hudaubaya/padan/rtl/README.md

# rtl/

RTL milik PADAN. Baseline TT07 yang disalin apa adanya ada di
[`baseline/`](baseline/) — jangan diubah; lihat [`docs/baselines.md`](../docs/baselines.md).
