hudaubaya/padan/tb/README.md

# tb/

Testbench cocotb untuk RTL PADAN (satu subdirektori per blok). Test baseline
TT07 tetap memakai testbench upstream di `rtl/baseline/<nama>/test/`.
