hudaubaya/padan/docs/laporan_padan.md

---
title: Laporan Proyek PADAN
subtitle: Identifikasi 1:N INT8 dengan ABFT, dari model hingga integrasi FPGA Kria KV260
date: Per 22 Oktober 2026 · repositori hudaubaya/padan, RTL terakhir berubah di PR #13 (atribut fsm_encoding)
lang: id-ID
---

<!--
Sumber laporan. docs/laporan/Laporan_PADAN.docx dibangkitkan dari berkas ini:
    make laporan
`make check-laporan` (bagian dari `make test`) gagal bila .docx tidak sinkron.
Angka di sini ditulis tangan dari docs/ dan log CI; perbarui saat repo berubah.
-->

# Ringkasan

PADAN sudah memiliki golden model, RTL lengkap, antarmuka bus (inti gaya
Avalon-MM dengan wrapper AXI4-Lite), penjaga keamanan (guard), dan paket
integrasi Kria KV260 (proyek Vivado dan host Python di Linux PS). Semuanya
terbukti **di simulasi** dan lulus CI. **Build Vivado 2026.1 sudah dijalankan
pengguna** dan lulus pemeriksaan timing, register redundan, dan CDC. Empat FSM
yang dikode ulang sudah diperbaiki di RTL, tetapi belum di-build ulang.
**Hasil board pertama** (dilaporkan pengguna, bitstream build pertama):
`padan_test.py` lulus 46/46 di KV260, dua kali berturut-turut. Uji tamper PMOD dan
bitstream dengan RTL terbaru belum dijalankan di board.

- **Fungsi:** 16 template × 128 byte INT8, skor s_j = Σ T[j,i]·p_i, keputusan
  MATCH / NO_MATCH / FAULT dengan latensi tetap 153 siklus.
- **Keamanan fault:** dari 48.765 fault bit tunggal yang disuntikkan lewat
  antarmuka bus, tidak satu pun menghasilkan MATCH yang salah.
- **Keamanan sistem:** pembatas percobaan, LOCK dengan τ terkunci, zeroize saat
  tamper atau FAULT berulang, dan FSM safe-state yang dibuktikan dengan SAT
  (Yosys).
- **Estimasi sumber daya (Yosys, K26):** semua di bawah 6% kapasitas. Masalah
  DSP di Cyclone V (9,8–17%) tidak berlaku lagi: 19 DSP48E2 = 1,5%.
- **Hasil Vivado 2026.1 (build pengguna, 21 Oktober 2026):**
  - Timing 100 MHz terpenuhi: WNS +3,68 ns, WHS +0,025 ns.
  - `padan_axil` memakai 1.559 LUT, 2.009 FF, 16 RAMB18, dan 21 DSP48E2.
  - FF `decision` 151 dan `guard` 103; FSM `guard` tidak dikode ulang.
  - CDC hanya ada pada `tamper_n`.

  Ada dua temuan:
  - `mac_array` memakai 18 DSP, bukan 16 (bagian 8).
  - Empat FSM lain dikode ulang Vivado. Sebagai tanggapan, `fsm_encoding =
    "none"` sudah dipasang, tetapi belum di-build ulang (risiko 5).
- **Hasil board KV260 (22 Oktober 2026, dilaporkan pengguna):**
  - Bitstream termuat lewat `xmutil loadapp padan`.
  - `pl_clk0` berjalan pada 99.999.999 Hz.
  - GUARD_STATUS awal `0x00000503` (OPEN).
  - `padan_test.py` lulus 46/46, dan hasil yang sama terulang dengan `exit 0`
    (bagian 5).
- **Temuan saat port:** Yosys untuk Xilinx menggabungkan FF kode STATUS
  sehingga jarak NO_MATCH → MATCH turun dari 4 ke 2 flip FF. Sudah diperbaiki
  (bagian 4).
- **Status:** RTL terakhir berubah di PR #13 (5b854d6, 22 Oktober 2026), yaitu
  atribut `fsm_encoding = "none"` di empat FSM. Logikanya tidak berubah. Sebelumnya RTL
  berubah di port KV260 (PR #8, 65e3eb8). Setiap merge
  dilakukan setelah CI hijau dan log-nya diperiksa. `make test` juga lulus
  (exit 0) di laptop pengguna (WSL), di luar CI.

## Cara membaca label

| Label | Arti |
|---|---|
| [Pasti] | Dibuktikan oleh simulasi, bukti formal, aljabar, atau struktur netlist di repo ini. |
| [Kemungkinan Besar] | Inferensi kuat yang belum dibuktikan di sini, misalnya perilaku Vivado. |
| [Menebak] | Mengisi celah informasi; perlu dicek. |
| (model) | Angka dari golden model Python, bukan dari RTL, FPGA, atau silikon. |
| estimasi Yosys | Pemetaan Yosys `synth_xilinx -family xcup`, bukan laporan Vivado. |

# Kronologi

Tahap 1–10 dilakukan pada 6 Oktober 2026, tahap 11–16 pada 17–22 Oktober 2026.
Setiap pull request di-merge setelah CI hijau.

| Tahap | Commit / PR | Isi |
|---|---|---|
| 1. Kerangka dan baseline | c319f85 | Struktur repo; tiga desain TT07 disalin apa adanya beserta lisensi dan SHA256SUMS |
| 2. Audit baseline | ecbc278 | Ketiga baseline diuji apa adanya (RTL dan netlist gate-level) terhadap model Python |
| 3. Golden model | d1a274d (PR #1) | Model integer PADAN, analisis batas 32 bit, data sintetis INT8 vs float, simulasi fault |
| 4. RTL inti | 982d2a6 (PR #2) | `template_mem`, `mac_array`, `abft_check` + test cocotb dan uji mutasi |
| 5. Keputusan dan bus | 4210629 (PR #3) | `decision` (dua komparator), `padan_avmm` (slave Avalon-MM), paritas probe |
| 6. FPGA DE10-Nano | 1ed2f89 (PR #4) | Komponen Platform Designer, skrip GHRD, SDC, skrip System Console |
| 7. Guard | 811f8ce (PR #5) | Pembatas percobaan, LOCK + τ terkunci, FAULT, tamper (KEY0 di DE10-Nano), zeroize, safe-state |
| 8. Injeksi fault debug | 2e694e4 (PR #6) | Port `DEBUG_FAULT` dan bukti bahwa build rilis tidak memuatnya |
| 9. Estimasi sumber daya | (tanpa commit) | Yosys `synth_intel_alm` per modul (Cyclone V; diganti di tahap 11) |
| 10. Laporan | 89875e3 (PR #7) | Laporan ini (Markdown → .docx), `make check-laporan` |
| 11. Port Kria KV260 | 65e3eb8 (PR #8) | `padan_axil` (AXI4-Lite), proyek Vivado, XDC tamper PMOD, host Python, inferensi UltraScale+, perbaikan `code_lo_n`; berkas DE10-Nano dihapus |
| 12. Perkakas `make` | da3e2ee (PR #10) | Pesan jelas bila cocotb belum terpasang; self-test `check_reports.py` tanpa baris FAIL palsu |
| 13. Uji di luar CI | (tanpa commit) | `make test` exit 0 di laptop pengguna (WSL) setelah `git pull` ke main yang memuat PR #10 |
| 14. Build Vivado pengguna | 5b854d6 (PR #13); laporan di `fpga/kv260/testdata` | Vivado 2026.1: timing, clock, register redundan, dan CDC lulus; 4 FSM dikode ulang, lalu `fsm_encoding = "none"` dipasang; `check_reports.py` kini juga memeriksa clock, CDC, dan FSM, dan diuji terhadap laporan asli |
| 15. Board KV260 pertama | (tanpa commit; dilaporkan pengguna) | Bitstream build pertama: `xmutil loadapp`, `pl_clk0` 99.999.999 Hz, `padan_test.py` PASS 46/46 dua kali |
| 16. Demo webcam | `sw/kv260/padan_cam.py` | Skrip pengguna masuk repo; galeri persisten (nama + template INT8, 0600) supaya wajah tetap dikenali di sesi baru; self-test di CI |

# 1. Baseline TT07 dan audit

Tiga desain Tiny Tapeout 07 disimpan **tanpa modifikasi** pada commit yang
di-tapeout. `make check-baseline` gagal bila satu byte berubah. Audit menguji
RTL dan netlist tapeout (sky130) dengan cocotb terhadap model maksud desain
(`docs/baseline_audit.md`).

| Baseline | Yang benar | Cacat yang ditemukan | Dipakai ulang |
|---|---|---|---|
| TinyTPU #0590 | Array sistolik 2×2 benar untuk 400 pasang matriks acak | `tx_ready` terlambat; akumulator 16 bit overflow; operasi kedua tanpa reset salah; 32 latch; register tanpa reset (X di netlist) | Konsep `mac.v` + `systolic.v`; kendali I/O ditulis ulang |
| Iterative MAC #0040 | Pengali 7×8 benar untuk 32.768 pasangan | Mode 0 selalu 0; `uio` dipakai dua arah; cabang mati; hasil terpotong | Hanya konsep |
| Vector CiSRAM #0642 | Dot product 8 elemen eksak; CLA terbukti formal (SAT) | Tidak ada cacat fungsional; hanya tak bertanda; tidak ada SRAM sungguhan | Ya: `MAC` dan `cla` |

16 test cacat ditandai `expect_fail`. Suite menjadi merah bila perilaku
baseline berubah, tanda dokumen audit perlu diperbarui. Nomor TT07 belum dicek
terhadap tinytapeout.com. [Kemungkinan Besar]

# 2. Golden model dan analisis

`model/padan.py` mendefinisikan skor, baris checksum C dan Cw, residu ABFT d1
dan d2, dan lokalisasi k = d2/d1 − 1. Semua angka di bagian ini berlabel
(model); rinciannya di `docs/padan_model.md`.

- **Semua besaran muat 32 bit bertanda.** [Pasti] Yang terbesar tanpa fault
  adalah Cw·p = 285.212.672 (model, 30 bit), dengan ruang sisa 7,53× terhadap
  2^31 − 1.
- **Baris checksum tidak muat INT8:** C butuh 12 bit dan Cw 16 bit, sehingga
  lane harus 16×8, bukan 8×8. [Pasti]
- **INT8 vs float:** kesepakatan keputusan ≥ 99,882% (model) untuk τ 0,15–0,50.
  Semua beda berada dalam 0,0047 dari ambang. FAR/FRR absolut tidak bermakna
  untuk biometrik nyata, karena data ini sintetis.
- **Fault tunggal:** deteksi 100% (model) untuk semua flip efektif. Pemeriksa
  32 bit salah tunjuk untuk flip bit 27–31 pada skor; pemeriksa 40 bit atau cek
  rentang memberi lokalisasi 100%. RTL memakai 40 bit.
- **Celah yang ditemukan model:** fault pada probe p tidak terlihat oleh ABFT.
  65.536 flip tidak terdeteksi, 229 di antaranya mengubah keputusan (model).
  Celah ini ditutup di RTL dengan paritas per byte.
- **Fault ganda:** dua flip bit 31 bisa saling meniadakan pada pemeriksa 32 bit,
  dan dua fault bisa salah lokalisasi. Lokalisasi cukup untuk pelaporan, tidak
  untuk koreksi otomatis.

# 3. RTL inti

Tiga modul Verilog-2001 dengan parameter rilis N = 16, D = 128, L = 16 lane
(`docs/rtl_padan.md`).

| Modul | Isi |
|---|---|
| `template_mem` | 16 bank block RAM × 144 word × 16 bit (T, C, Cw); hanya bisa ditulis; generator memperbarui C dan Cw di setiap tulis byte |
| `mac_array` | 16 lane MAC 16×8, adder tree, akumulator 32 bit; satu dot product per 8 siklus; 18 baris per MATCH (16 skor + C·p + Cw·p); probe 1.024 bit dengan paritas per byte |
| `abft_check` | S1, S2, d1, d2 dalam 40 bit; lokalisasi tanpa pembagi, maksimal 16 langkah |

- **38.112 fault** (lane, akumulator, setiap bit memori) terdeteksi dengan indeks
  benar; tidak ada alarm palsu pada 1.317 run bersih. [Pasti]
- **Biaya ABFT:** 16 siklus (+12,5%) untuk dua baris checksum.
- **Uji mutasi:** mutan `no_c`, `no_cw`, dan `weight_j` terbunuh. Mutan `no_c` dan
  `no_cw` membuktikan bahwa test tanpa fault saja tidak cukup, karena pemeriksa
  yang setengah mati tetap diam.

# 4. Keputusan dan antarmuka bus

`decision.v` memakai dua komparator yang ditulis berbeda (diversitas). τ di
komparator B disimpan sebagai komplemen; tanpa itu Yosys menggabungkan register
keduanya. `padan_avmm.v` adalah inti dengan slave Avalon-MM internal tanpa jalur
baca untuk template, probe, atau skor (`docs/rtl_decision.md`). Di KV260 ia
dibungkus `padan_axil.v` (AXI4-Lite) tanpa mengubah peta register.

| Kode STATUS | Arti |
|---|---|
| `0000` | NONE (belum ada keputusan) |
| `0101` | NO_MATCH (tanpa indeks, agar identitas terdekat tidak bocor) |
| `1010` | MATCH; indeks dikeluarkan dua kali (idx dan ~idx) |
| `1111` | FAULT: ABFT gagal, paritas probe salah, atau komparator tidak sepakat |

- **814 keputusan** identik dengan model, termasuk seri dan nilai ekstrem.
- **48.765 fault** (datapath, memori, probe, register komparator, sinyal error,
  register keluaran): tidak satu pun menghasilkan MATCH yang salah. [Pasti]
- **Latensi tetap 153 siklus** untuk MATCH, NO_MATCH, dan FAULT, sehingga tidak
  ada kanal samping waktu.
- **Mutan `no_parity`** membuktikan temuan model: satu flip bit probe tanpa
  paritas membuat impostor MATCH.
- **Kode STATUS harus bertahan di netlist.** Kedua setengah kode legal selalu
  sama, dan Yosys `synth_xilinx` menggabungkan FF `code[1:0]` dengan
  `code[3:2]` (`synth_intel_alm` tidak). Akibatnya NO_MATCH → MATCH hanya butuh
  2 flip FF, bukan 4. [Pasti, Yosys] Perbaikan: setengah bawah disimpan terbalik
  (`code_lo_n`); FF `decision` kembali 151 di kedua alur, dan test fault kini
  membalik FF yang sebenarnya.

# 5. Integrasi FPGA Kria KV260

Board target sekarang Kria KV260 (Zynq UltraScale+ K26). Paket DE10-Nano
(tahap 6) dihapus. Build Vivado 2026.1 sudah dijalankan pengguna (21 Oktober
2026), dan bitstream-nya sudah diuji di board KV260 oleh pengguna (22 Oktober
2026, hasil di bawah).

| Bagian | Isi |
|---|---|
| `rtl/padan_axil.v` | Slave AXI4-Lite di atas `padan_avmm`. AW/W boleh datang dalam urutan apa pun; WSTRB ≠ `1111` → SLVERR tanpa efek; B ditahan sampai inti menerima tulis (zeroize, byte template). |
| `fpga/kv260/create_project.tcl` | Part `xck26-sfvc784-2LV-c`, board part KV260, PS → `M_AXI_HPM0_FPD` → SmartConnect → `padan_0` di `0xA000_0000` (4 KiB), `pl_clk0` 100 MHz. |
| `fpga/kv260/padan_kv260.xdc` | `tamper_n` di H12 (PMOD J2), LVCMOS33, pull-up, false path. H12/LVCMOS33 dikutip dari XDC resmi Xilinx Kria-PYNQ. [Pasti] Bahwa itu pin fisik 1 di J2: [Kemungkinan Besar]. |
| `fpga/kv260/build.tcl`, `check_reports.py` | Bitstream, laporan, XSA; pemeriksaan RAMB18 16, DSP `mac_array` 16–18, FF `decision` 151, `guard` 103, WNS/WHS/WPWS ≥ 0, `clk_pl_0` 10 ns, CDC hanya `tamper_n`, tidak ada FSM modul PADAN yang dikode ulang. |
| `sw/kv260/padan_test.py` | Host di Linux PS lewat `/dev/mem` (pustaka standar Python). Identifikasi baca-saja sebelum menulis; 3 galeri, 46 kasus dari model, pindai 1.024 word. |
| `sw/kv260/padan_cam.py` | Demo webcam: YuNet + SFace (128-D) → INT8 → PADAN. Galeri nama + template INT8 disimpan di `padan_galeri.json` (izin 0600, tidak dienkripsi, diabaikan git) dan ditulis ulang ke PADAN setiap skrip mulai. Self-test di CI tanpa kamera; kamera dan akurasi wajah nyata belum diuji. |

- **Yang diuji di CI tanpa Vivado dan board:**
  - `padan_axil`: 6 test protokol (urutan AW/W, backpressure B/R, SLVERR, AR
    bersamaan, tamper) dan 8 mutan, semua terbunuh. [Pasti]
  - `padan_test.py` tanpa diubah melawan RTL lewat AXI: 46/46 PASS tanpa
    pelanggaran protokol; fault memori terdeteksi dan HALT setelah FAULT ke-3;
    base salah tidak menulis apa pun. [Pasti, simulasi]
  - Skrip Vivado di tclsh dengan stub: nilai kunci konsisten dengan RTL dan
    host, 4 kondisi error memberi pesan jelas.
- **Dijalankan pengguna di luar CI:** build Vivado 2026.1 (lulus),
  pembangkitan `pl.dtsi`, dan uji di board (tabel berikut).

**Hasil board KV260** (22 Oktober 2026; dijalankan dan dilaporkan pengguna;
bitstream build pertama, sebelum `fsm_encoding` ditambahkan di PR #13). Output
perintah dikutip apa adanya:

| Butir | Hasil |
|---|---|
| `xmutil loadapp padan` | `padan: loaded to slot 0`; `listapps` menunjukkan `padan` di slot 0 |
| `dmesg` | Peringatan overlay "memory leak will occur if overlay removed" (umum, tidak berbahaya [Kemungkinan Besar]); pada pemuatan pertama `set divider failed for pl0_ref_div1, ret = -13` |
| `clk_summary` | `pl0_ref` 99.999.999 Hz (`pl0_ref_mux` 1.499.999.985 Hz ÷ 15), aktif |
| GUARD_STATUS awal | `0x00000503` (OPEN, gagal 0/5, alasan BOOT) |
| `padan_test.py` run 1 | `PADAN KV260: PASS (46 kasus, 3 galeri, pindai alamat bersih)` |
| `padan_test.py` run 2 (`timeout 120`) | PASS yang sama, `exit 0` |
| Uji tamper PMOD | belum |
| Bitstream RTL terbaru (PR #13) | belum |

- **Error divider clock tidak berdampak:** frekuensi akhirnya sesuai permintaan
  `pl.dtsi` dan tidak melebihi 100 MHz, sehingga margin timing Vivado tetap
  berlaku [Pasti, dari `clk_summary`].
- **Satu run yang dihentikan dengan Ctrl+C** (exit 130) tidak dihitung. Run
  ulang dengan `timeout` lulus.
- **Yang terbukti:** jalur PS → SmartConnect → `padan_axil` → inti, 46
  keputusan yang sama dengan model, dan pindai 1.024 alamat yang bersih.
  Hasilnya hanya berlaku untuk board, bitstream, dan versi repo itu.
- **Tidak tercakup:** tamper fisik, zeroize memori yang sebenarnya (tidak ada
  jalur baca template), dan perilaku di bawah fault nyata.

# 6. Guard: keamanan di tingkat sistem

`guard.v` mengendalikan izin bus. Setiap reset melakukan zeroize sebelum
perangkat bisa dipakai (`docs/rtl_guard.md`).

| Fungsi | Perilaku |
|---|---|
| Pembatas percobaan | K = 5 NO_MATCH berturut-turut → LOUT (keluar hanya lewat reset); MATCH menolkan penghitung |
| LOCK | Setelah LOCK, template tidak bisa ditulis atau dihapus; probe dan MATCH tetap bisa |
| τ terkunci | Di LOCKD, decision memakai GUARD_TAU, bukan τ dari host |
| FAULT | Penghitung kumulatif; FAULT ke-3 → zeroize → HALT |
| Tamper | Pin PMOD J2 (KV260), sinkronisasi 2-FF → zeroize → HALT |
| Safe-state | State 4 bit berparitas genap; kode ilegal atau ketidakcocokan penghitung/komplemen → zeroize → HALT |

**τ terkunci tidak ada di spesifikasi awal.** Tanpanya, host cukup menulis
τ = −2^31 untuk mendapat MATCH dan menolkan penghitung, sehingga pembatas
percobaan tidak berarti. [Pasti]

- 9 test dengan parameter rilis. Zeroize dibuktikan dengan memindai seluruh
  16 × 144 word memori dan register probe di simulasi.
- Bukti SAT Yosys setelah sintesis: setiap state ilegal mematikan semua izin dan
  menuju zeroize; ada kontrol negatif.
- 12 mutan guard terbunuh, termasuk clear yang melewatkan baris checksum dan
  sinkronisasi tamper 1-FF.

# 7. Injeksi fault debug (DEBUG_FAULT)

Build debug punya register DBG_FAULT untuk menambahkan delta ke produk satu
lane, serta DBG_ABFT untuk membaca hasil lokalisasi. Build rilis **tidak
memuat** port, register, atau logikanya (`docs/rtl_debug_fault.md`).

- **Delta aditif, bukan pengganti.** Dengan delta aditif, residu ABFT hanya
  bergantung pada delta dan baris. Dengan nilai pengganti, residu membocorkan
  T·p. [Pasti, aljabar]
- 288 injeksi (16 lane × 18 baris): semuanya FAULT; 256 dilokalisasi ke
  barisnya, 32 terdeteksi di baris checksum.
- Bukti build rilis: hasil praproses dan netlist Yosys sebelum optimasi tidak
  memuat jejak `dbg`; build debug dipakai sebagai kontrol positif.

# 8. Estimasi sumber daya

Estimasi Yosys (`synth_xilinx -family xcup -flatten`) untuk Zynq UltraScale+
K26 dengan parameter rilis. LUT = LUT1–LUT6; FF = FDRE/FDCE/FDPE/FDSE. Kapasitas:
1.248 DSP dari data AMD; LUT, FF, dan block RAM dari ingatan atas tabel K26 dan
belum dicek ke datasheet DS987. [Kemungkinan Besar]

| Modul | LUT | FF | DSP48E2 | Block RAM |
|---|---|---|---|---|
| `mac_array` | 3.121 | 1.866 (+11 SRL16E) | 16 | – |
| `abft_check` | 474 | 290 | 2 | – |
| `template_mem` | 286 | 86 | 1 | 16 RAMB18E2 |
| `decision` | 135 | 151 | – | – |
| `guard` | 169 | 103 | – | – |
| `padan_avmm` (inti) | 4.309 | 2.559 | 19 | 16 RAMB18E2 |
| **`padan_axil` (top KV260)** | **4.358** | **2.631** | **19** | **16 RAMB18E2** |

| Sumber daya | Estimasi | Kapasitas K26 | % |
|---|---|---|---|
| LUT | 4.358 | ± 117.120 | 3,7% |
| FF | 2.631 | ± 234.240 | 1,1% |
| RAMB18 | 16 | ± 288 | 5,6% |
| DSP48E2 | 19 | 1.248 | 1,5% |

**Keputusan DSP dari Cyclone V tidak diperlukan lagi.** Di Cyclone V, 19
pengali menjadi 11–19 blok DSP (9,8–17%). Di K26 satu DSP48E2 memuat satu
pengali 16×8, dan totalnya 1,5%. Menghapus 3 pengali di `abft_check` dan
`template_mem` tidak lagi sepadan dengan risiko mengubah RTL yang sudah
terverifikasi.

Angka yang dikunci CI adalah jumlah primitif keras dan FF register redundan,
bukan LUT.

**Hasil Vivado 2026.1** (build pengguna, 21 Oktober 2026; laporan asli di
`fpga/kv260/testdata/vivado_2026.1`) [Pasti untuk build itu]:

| Modul | LUT | FF | DSP48E2 | Block RAM |
|---|---|---|---|---|
| `mac_array` | 520 | 1.237 (+11 SRL) | 18 | – |
| `abft_check` | 240 | 280 | 2 | – |
| `template_mem` | 197 | 86 | 1 | 16 RAMB18 |
| `decision` | 165 | 151 | – | – |
| `guard` | 424 | 103 | – | – |
| **`padan_axil`** | **1.559** | **2.009** | **21** | **16 RAMB18** |
| Seluruh desain (dengan SmartConnect) | 1.996 | 2.459 | 21 | 16 RAMB18 |

- **DSP `mac_array` = 18, bukan 16 seperti Yosys.**
  - Daftar sel DSP menunjukkan 16 DSP lane yang menyerap `g_sum4[*].sum` lewat
    kaskade, ditambah 2 DSP (`tree0`, `tree_reg`) sebagai adder `tree`.
  - Akumulator `acc` tetap di fabric.
  - Tidak ada pengali yang dipecah, jadi tidak ada yang perlu diubah di RTL.
    `check_reports.py` kini menerima 16–18 DSP.
- **`guard` memakai 424 LUT di Vivado, sedangkan Yosys 169.** Netlistnya jelas
  berbeda, dan bukti SAT safe-state hanya berlaku untuk netlist Yosys
  (risiko 1).
- **Timing.** Jalur terlambat ada di `template_mem`, dari block RAM ke DSP
  `g_wdelta`, dengan slack 3,68 ns pada 10 ns.

# 9. Verifikasi dan CI

`make test` menjalankan semua target di bawah: 30 menit lokal, 33 menit di CI
(job `cocotb` PR #8, 04:55–05:28 UTC, 17 Oktober 2026). CI GitHub
Actions menjalankannya di setiap PR dan setiap push ke main. Setiap merge
dilakukan setelah CI hijau dan log-nya diperiksa.

Di luar CI, `make test` butuh `python3 -m pip install -r requirements.txt`
(cocotb 1.8.1, numpy) serta Icarus Verilog, Yosys, tclsh, dan pandoc. Tanpa
cocotb, setiap target simulasi berhenti dengan pesan yang menyebut perintah
pemasangan itu (PR #10).

Pada 20 Oktober 2026 `make test` dijalankan di laptop pengguna (WSL, venv
Python) dan selesai dengan exit 0. Ini mereproduksi hasil CI di mesin kedua,
bukan bukti Vivado atau board.

**Cara membaca output.** Ukurannya adalah exit code `make test` (0 = semua
target lulus), bukan ada atau tidaknya kata "FAIL". Kata itu memang muncul pada
hasil yang benar:

- di kepala tabel ringkasan cocotb (`FAIL=0`);
- pada log test negatif `tb/kv260`, yang sengaja membuat skrip host gagal
  (memori dibalik → `PADAN KV260: FAIL … HALT`; guard LOCKD → skrip menolak);
  test-nya sendiri lulus bila skrip melaporkan FAIL.

`SKIP=1` pada dua audit gate-level (`tinytpu`, `iterative_mac`) juga wajar: test
yang membaca sinyal internal RTL dilewati karena sinyal itu tidak ada di
netlist. Baris yang diawali `FAIL` di awal baris (`grep "^FAIL"`) tidak boleh
ada. Kode sebelum PR #10 masih mencetak lima baris seperti itu dari kasus
negatif self-test `check_reports.py`; bila muncul, salinan lokal belum
diperbarui.

| Target | Isi | Hasil terakhir |
|---|---|---|
| `check-baseline`, `test-baseline`, `test-audit` | Integritas baseline, test upstream, audit RTL + gate-level + bukti SAT CLA | lulus |
| `test-model`, `check-model-report` | Self-test model; dokumen model sinkron | lulus |
| `test-rtl` | Inti RTL vs model, 38.112 fault | 7/7 |
| `test-rtl-avmm` | Bus + decision, 814 keputusan, 48.765 fault | 7/7 |
| `test-rtl-guard` | Guard, parameter rilis | 9/9 |
| `check-rtl-guard-safe` | Bukti SAT safe-state | 21 bukti |
| `test-rtl-mutation` | Mutan RTL harus terbunuh (3 inti, 3 decision, 12 guard, 8 AXI) | 26/26 |
| `check-rtl-infer` | Yosys UltraScale+: 16 RAMB18E2, 16 + 3 DSP48E2, tanpa LUTRAM; FF `decision` 151, `guard` 103 | lulus |
| `test-rtl-debug`, `check-rtl-release` | Build debug; bukti build rilis bersih (termasuk port `padan_axil`) | 4/4; PASS |
| `test-rtl-axil` | Wrapper AXI4-Lite, monitor protokol | 6/6 |
| `test-kv260-scripts` | Skrip Vivado (stub), parser laporan (laporan asli Vivado 2026.1 + 13 kasus negatif), host KV260 vs RTL lewat AXI | 5/5 |

# 10. Batas dan risiko terbuka

1. **Uji board baru sebagian.** `padan_test.py` lulus di board dengan bitstream
   build pertama (bagian 5). Tamper fisik dan bitstream terbaru belum diuji.
   Klaim keamanan fault tetap berasal dari simulasi RTL.
   - Build Vivado 2026.1 sudah memastikan beberapa hal: timing 100 MHz, jumlah
     FF register redundan, block RAM/DSP, dan FSM `guard` yang tidak dikode
     ulang.
   - Logika safe-state baru dibuktikan dengan SAT pada netlist Yosys. Netlist
     `guard` di Vivado berbeda (424 LUT, Yosys 169).
2. **Pemuatan bitstream di Linux KV260** (overlay device tree, `xmutil`) adalah
   bagian paling tidak pasti; tanpa overlay `pl_clk0` mungkin mati dan akses
   AXI menggantung. [Menebak] Status saat ini:
   - Overlay dari `pl.dtsi` sudah berhasil dimuat di board dengan `xmutil`.
   - `pl_clk0` berjalan pada 99.999.999 Hz.
   - `firmware-name` (`padan_kv260.bit.bin`) sudah disesuaikan di panduan.
   - Sisa risiko: image Linux atau firmware lain bisa berperilaku berbeda,
     misalnya error divider clock yang muncul saat pemuatan pertama.
3. **Template selalu ada di luar chip.** Keadaan guard volatil dan setiap reset
   menghapus template, jadi host harus mengirim ulang template setiap boot.
   - `padan_cam.py` melakukannya dari `padan_galeri.json`.
   - Berkas itu berisi template wajah sukarelawan dan tidak dienkripsi;
     perlindungannya hanya izin 0600 (root).
   - Siapa pun yang punya akses root atau kartu SD bisa membaca template, jadi
     perlindungan zeroize di FPGA tidak berlaku untuk salinan di host.
4. **Pembatas hanya menghitung kegagalan berturut-turut.** Penyerang dengan satu
   probe sah bisa menyelipkannya setiap 4 percobaan.
5. **Fault kendali belum disimulasikan:** sequencer, tag baris, FSM. Flip pada
   tag baris bisa membuat ABFT dan kedua komparator salah secara konsisten.
   [Kemungkinan Besar]
   - Vivado 2026.1 mengode ulang FSM `template_mem` dan `abft_check`
     (sequential) serta `padan_avmm` dan `padan_axil` (one-hot) [Pasti, log
     sintesis].
   - Cabang `default` di RTL, yaitu jalan pulang ke IDLE dari state ilegal,
     kemungkinan besar hilang. Satu flip pada register one-hot bisa membuat bus
     atau sequencer macet sampai reset [Kemungkinan Besar].
   - Perbaikannya: `fsm_encoding = "none"` dipasang pada keempat register
     (22 Oktober 2026). Simulasi tidak terpengaruh. Yosys juga mematuhinya:
     estimasi `padan_axil` naik dari 4.248 menjadi 4.358 LUT, dan jumlah DSP,
     block RAM, serta FF register redundan tidak berubah [Pasti].
   - Sudah di-merge di PR #13 (5b854d6). Efeknya di Vivado dan board belum
     diverifikasi; perlu build ulang.
6. **Fault ganda** bisa salah lokalisasi; lokalisasi tidak boleh dipakai untuk
   koreksi otomatis.
7. **Flip dua bit** bisa membawa LOCKD ke OPEN; flip satu bit selalu tertangkap.
8. **Bitstream debug adalah alat DoS** dan bisa dibangun lewat `verilog_define`
   Vivado di luar repo. Penandanya STATUS[31] = 1.
9. **Tamper PMOD dengan pull-up internal** peka terhadap kabel lepas atau
   sentuhan ke GND; satu glitch sudah menghapus enrollment.
10. **Hasil INT8 vs float memakai data sintetis;** tidak ada klaim akurasi
   biometrik nyata. `padan_cam.py` memakai ambang kosinus SFace float (0,363)
   yang belum dikalibrasi untuk INT8 dengan wajah nyata.

# 11. Langkah berikutnya

1. **Build ulang di Vivado** setelah `fsm_encoding = "none"` dipasang di empat
   FSM (risiko 5), lalu jalankan `check_reports.py`. Pemeriksaan FSM harus
   PASS, dan angka utilisasi serta timing dibandingkan dengan build pertama.
2. **Cek pin H12 = PMOD J2 pin 1** di skematik carrier KV260 sebelum menyambung
   kabel tamper.
3. **Uji di board dengan bitstream baru:** `padan_test.py` (harus PASS
   46/46), lalu uji tamper PMOD manual (`docs/fpga_howto.md` bagian 7).
4. **Pertimbangkan penghitung kegagalan total atau pembatas laju** bila ancaman
   probe sah relevan.
5. **Tambah simulasi fault kendali** (sequencer, tag baris) atau duplikasi
   kendali.
