hudaubaya/padan/tb/common/tb_tt.v

// Toplevel audit untuk satu proyek Tiny Tapeout, level pin saja.
// TT_TOP = nama top module (didefinisikan oleh tb/audit/audit.mk). Dengan
// GL_TEST, DUT adalah netlist tapeout yang membutuhkan pin daya.
`default_nettype none
`timescale 1ns / 1ps

module tb ();
  reg        clk;
  reg        rst_n;
  reg        ena;
  reg  [7:0] ui_in;
  reg  [7:0] uio_in;
  wire [7:0] uo_out;
  wire [7:0] uio_out;
  wire [7:0] uio_oe;

`ifdef WAVES
  initial begin
    $dumpfile("tb.vcd");
    $dumpvars(0, tb);
  end
`endif

  `TT_TOP dut (
`ifdef GL_TEST
      .VPWR   (1'b1),
      .VGND   (1'b0),
`endif
      .ui_in  (ui_in),
      .uo_out (uo_out),
      .uio_in (uio_in),
      .uio_out(uio_out),
      .uio_oe (uio_oe),
      .ena    (ena),
      .clk    (clk),
      .rst_n  (rst_n)
  );
endmodule
