hudaubaya/padan/(commit log)

2026-10-06 Audit TT07 baselines as-is against Python models
    Test the three vendored baselines without modifying them, at pin level on
    both the RTL and the tapeout gate-level netlist (sky130_fd_sc_hd cell
    models, pinned), against reference models in model/:
    - TinyTPU #0590: the 2x2 systolic core computes X @ Y correctly, but
    tx_ready lags data by one cycle (T1), bit 0 of z00 is sampled before
    accumulation finishes (T2), the 16-bit accumulator overflows on
    2*255^2 (T3), a second operation without reset is wrong (T4),
    init_delay has no reset so the netlist goes X after a single reset
    (T5), and dff_mem infers 32 latches (T6).
    - Iterative MAC #0040: the 7x8 multiplier is correct for all 32768
    p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
    [audit_util.py, cla_prove.v, gl_stubs.v, tb_tt.v, test.py]
2026-10-06 Add decision with dual comparators and minimal Avalon-MM slave
    - rtl/decision.v: 1:N identification with threshold from the score stream,
    two diverse comparators (signed compare vs 33-bit difference sign), each
    with its own tau copy (B stores ~tau so synthesis cannot merge them).
    The decision is held as FAULT when ABFT fails, probe parity fails, or
    the comparators disagree. Status codes are Hamming-distance >= 2 apart
    (MATCH/NO_MATCH 4 apart) and the index is output twice (idx, ~idx); no
    index is reported for NO_MATCH.
    - rtl/padan_avmm.v: minimal Avalon-MM slave with ENROLL, PROBE, CLR, MATCH
    (writedata = tau) and STATUS. Only STATUS is readable; template, probe,
    scores and c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
    [abft_check.v, decision.v, mac_array.v, mutate.py, padan_avmm.v, tb_avmm.v, test_avmm.py]
2026-10-06 Add guard: retry limiter, enrollment LOCK with locked tau, FAULT counter, tamper zeroize, safe-state FSM
    rtl/guard.v sits inside padan_avmm and gates the bus engine:
    - consecutive-failure limiter (K = 5 at boot, GUARD_K in OPEN) -> LOUT
    - GUARD_LOCK ("LOCK") -> LOCKD: no enroll/clear; GUARD_TAU is used as the
    decision threshold, so a host cannot bypass the limiter with a low tau
    - cumulative FAULT counter; FAULT_MAX = 3 -> zeroize -> HALT
    - tamper_n (KEY0) through a 2-FF synchronizer -> zeroize -> HALT
    - even-parity state encoding; illegal states and value/complement mismatches
    -> zeroize -> HALT; every reset zeroizes before OPEN
    - zeroize clears all template, C and Cw words and the prob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
    [guard.v, mutate.py, padan_avmm.v, tb_avmm.v, test_avmm.py]
2026-10-06 Add host-controlled fault injection under DEBUG_FAULT, and prove the release build has none of it
    Debug build only (`define DEBUG_FAULT):
    - mac_array gets dbg_* ports that ADD a signed 16-bit delta to the product of
    one lane at one (row, chunk). Additive on purpose: the score error equals the
    delta, so ABFT residues are d1 = delta, d2 = (j+1)*delta, independent of the
    template and probe (a replace/XOR injection would leak T[j,i]*p_i).
    - padan_avmm: DBG_FAULT (0x307, W, OPEN only) and DBG_ABFT (0x308, R:
    loc_idx, loc_vld, err, chk, done); STATUS[31] = 1 marks a debug build.
    tb/debug (make test-rtl-debug): 16 lanes x 18 rows injected; every decision
    is FAULT, score-row faults localize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
    [mac_array.v, padan_avmm.v, test_avmm.py]
2026-10-06 Add project report (docx) from TT07 baselines through resource estimate
    docs/laporan/Laporan_PADAN.docx summarizes the work as of main @ 258c487:
    baseline audit, golden model, RTL core, decision and Avalon-MM slave,
    DE10-Nano integration, guard, DEBUG_FAULT injection, Yosys resource
    estimate, verification/CI status, open risks and next steps. It states up
    front that nothing has been compiled in Quartus or run on a board.
    docs/laporan/build_laporan.js regenerates it (npm docx); its figures are
    written by hand from docs/ and the CI logs, so they must be updated when the
    repo changes.
    Claude-Session: https://claude.ai/code/session_01JWHc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
2026-10-17 Port FPGA ke Kria KV260: wrapper AXI4-Lite, proyek Vivado, host Python
    - rtl/padan_axil.v: slave AXI4-Lite di atas padan_avmm (peta register tetap);
    WSTRB parsial -> SLVERR tanpa efek, B ditahan sampai inti menerima tulis.
    - rtl/decision.v: setengah bawah code disimpan terbalik (code_lo_n). Yosys
    synth_xilinx menggabungkan code[1:0] dengan code[3:2], sehingga NO_MATCH ->
    MATCH hanya butuh 2 flip FF; FF decision kembali 151.
    - Atribut RTL ke Vivado: ram_style, use_dsp, dont_touch, ASYNC_REG.
    - tb/axil: 6 test protokol + monitor; 8 mutan AXI di mutate.py (26 total).
    - fpga/kv260: create_project.tcl, build.tcl, XDC tamper PMOD (H12),
    check_reports.py; tb/kv260/check_tcl.py memeriksa skr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
2026-10-17 Laporan: durasi make test dari CI PR #8; tutup pipe di test host KV260
    Claude-Session: https://claude.ai/code/session_01JWHcwMqQzXkB9LnTCQYUWo
2026-10-20 Laporan: uji make test di luar CI; cara membaca baris FAIL yang disengaja
    Acuan laporan kini 'kode terakhir berubah di da3e2ee', bukan hash main,
    supaya PR yang hanya berisi laporan tidak membuatnya usang.
    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
2026-10-22 Laporan: hasil board KV260 pertama; panduan: tanpa devmem2, cek listapps dan clock
    Hasil board yang dilaporkan pengguna (22 Oktober 2026, bitstream build
    pertama): xmutil loadapp padan di slot 0, pl0_ref 99.999.999 Hz (error
    divider -13 tidak berdampak), GUARD_STATUS 0x503, padan_test.py PASS 46/46
    dua kali (exit 0). Uji tamper dan bitstream RTL terbaru belum dijalankan.
    Panduan: devmem2 tidak ada di image Ubuntu Kria, jadi diganti fungsi baca
    Python 32 bit. Ditambahkan juga langkah listapps (k26-starter-kits aktif saat
    boot) dan cek clk_summary, serta nilai GUARD_STATUS yang diharapkan pada uji
    tamper.
    Claude-Session: https://claude.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
2026-10-22 padan_cam.py: galeri persisten (nama + template INT8, izin 0600); self-test di CI
    Sesi baru (skrip, loadapp, reboot) sekarang menulis ulang galeri ke PADAN,
    sehingga wajah yang sudah di-enroll tetap dikenali. PADAN tetap
    meng-zeroize templatenya sendiri; salinan di host adalah satu-satunya yang
    bertahan.
    - Gallery: JSON berisi version, D, SCALE, dan slot -> {nama, 128 INT8}.
    Ditulis atomik dengan izin 0600; izin longgar diperketat saat dibaca;
    berkas tidak sah ditolak (INT8, panjang, slot, SCALE).
    - Perintah baru: ls, d <slot> (template nol), forget (ENROLL_CLR + hapus
    berkas). --gallery FILE dan --no-gallery (perilaku lama, tanpa disk).
    - Di LOCKD, enroll ditolak PADAN: galeri tidak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
